Vasilyka/Voice-planner/README.md

# Voice-planner

Портативный голосовой планировщик на ESP32-S3. Удерживайте кнопку, чтобы записать команду, и отпустите для отправки. Локальный сервер распознаёт речь через Yandex SpeechKit, разбирает команду через YandexGPT и формирует таблицу дел для e-paper-дисплея.

Голосом можно добавлять, удалять, отмечать выполненными и восстанавливать дела.

- [Компоненты и схема](hardware/README.md)
- [Прошивка и подключение](firmware/README.md)
- [Запуск сервера и голосовые команды](server/README.md)
- [Архитектура](docs/ARCHITECTURE.md)
