Vasilyka/Voice-planner/docs/Лифлет_Voice_Planner.docx

Голосовой Планировщик с AI

## Название и описание

Портативное устройство для голосового ввода дел и просмотра списка на экране. Пользователь удерживает кнопку и произносит команду; запись передаётся на сервер для распознавания. Результат обработки возвращается на дисплей в виде таблицы задач.

## Команда

Участники: Калачиков Василий, Б04-507.

Роли: весь пласт задач лежит на единственном человеке в команде.

## Telegram и GitHub

GitHub Telegram

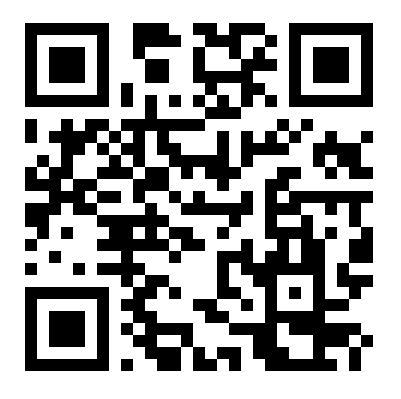
[picture p1: figure]
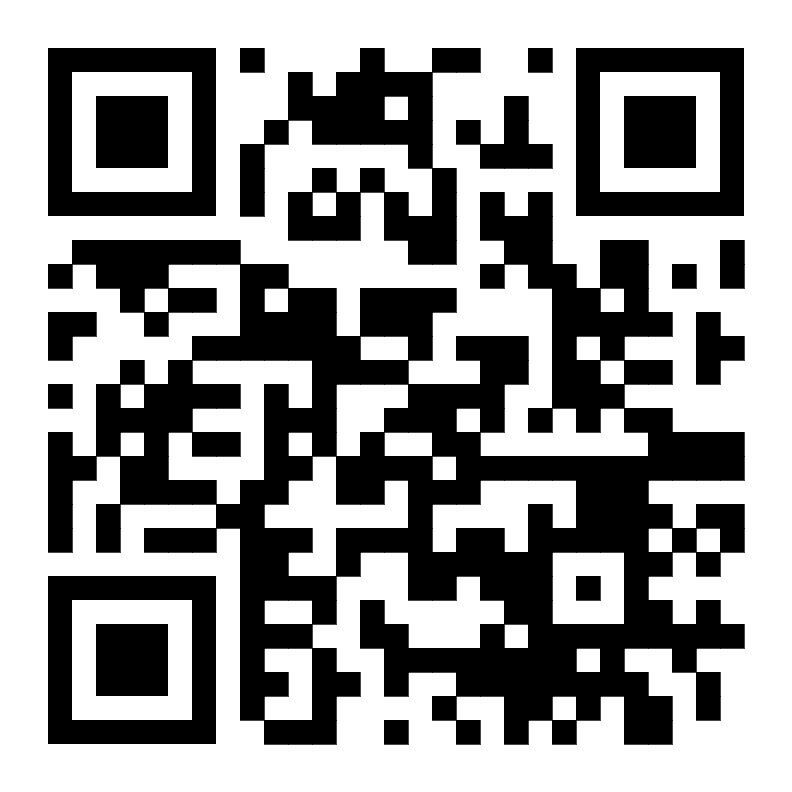
[picture p2: figure]

Github: Vasilyka/Voice-planner

Telegram: @Quantumxy

# Технические характеристики устройства

## Электронные компоненты

Сенсор: цифровой микрофон INMP441 — воспринимает звук и речь пользователя через I2S.

Микроконтроллер: ESP32-S3 — запись, обмен по Wi-Fi и управление экраном.

Вывод и индикация: e-paper GDEM035T81 с адаптером DESPI-C02 и два светодиода. Механических актуаторов нет.

## Основные параметры:

• Экран: 3,5″, 184 × 384 пикселя.
• Аудио: WAV, моно, 16 бит, 16 кГц.
• Запись: до 30 с при доступной PSRAM.
• Связь: Wi-Fi, передача по HTTP.

## Функциональная схема

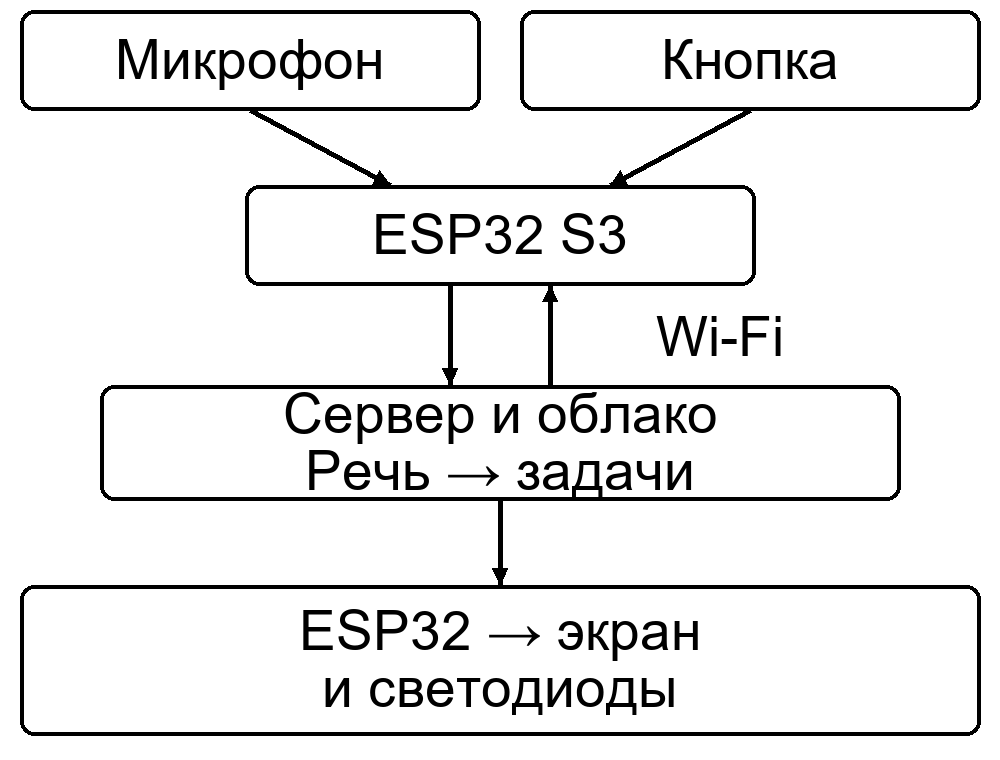
[picture p3: figure]

# Сценарий использования

## Ввод информации и управление

1. Включить устройство и дождаться подключения к Wi-Fi.

2. Удерживать кнопку и произнести дело, например: «Завтра в шесть вечера лекция по физике».

3. Отпустить кнопку. Устройство отправит запись на сервер; после обработки обновится список дел.

В программной версии предусмотрены голосовые команды добавления, удаления, выполнения и восстановления дел. Например: «Удали задачу номер пять».

## Получение информации

Экран показывает состояние устройства, обработку записи и таблицу дел. Светодиоды сигнализируют о записи или передаче и подключении к Wi-Fi.

## Настройка

Сеть Wi-Fi и адрес сервера задаются перед загрузкой прошивки. Для распознавания нужны работающий сервер, доступ в интернет и настроенный облачный ключ.

# Инженерная задача

Основной технический вызов — размещение всех модулей в портативном корпусе с безрамочным экраном.

Также нужно объединить запись звука, сетевой обмен и медленное обновление e-paper так, чтобы обновление экрана не прерывало запись речи. Для этого обработка дисплея и получение результатов с сервера вынесены в отдельные задачи.

## Результаты испытаний

Время обработки: ~ секунда
Автономность: (нужно проверить)
Габариты и масса: (нужно измерить)

# Прогресс проекта

Статус: первый рабочий прототип.

## Было заявлено

Голосовой ввод дел и вывод списка на экран.

## Сделано

Распознавание речи и вывод дел на экран работают. Добавлены команды выполнения, удаления и восстановления дел.

## Осталось

Добавить 2 светодиода, улучшить прошивку.

Можно добавить 2 кнопки управления и реализовать прошивку для них.

# Визуализация устройства

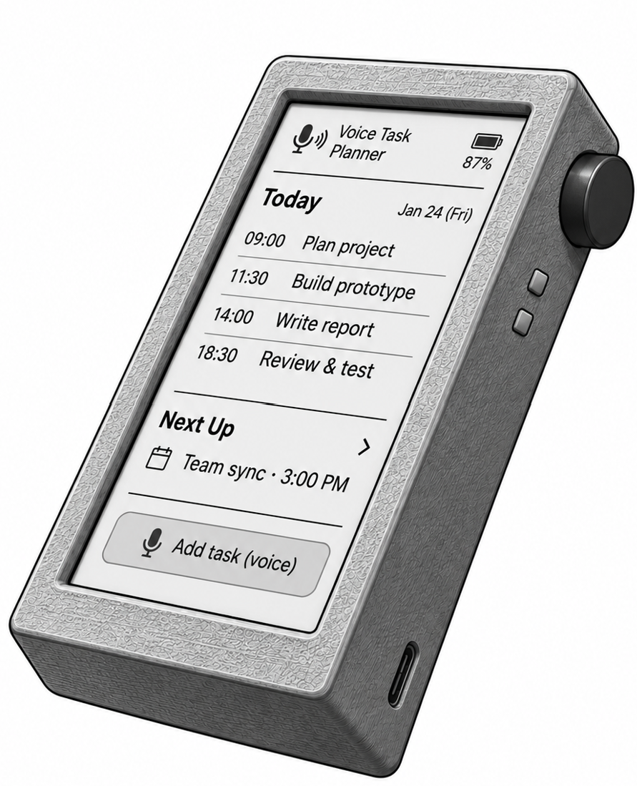
[picture p4: figure]

Эскиз
