Vasilyka/Voice-planner/hardware/Схема подключения 2.jpg

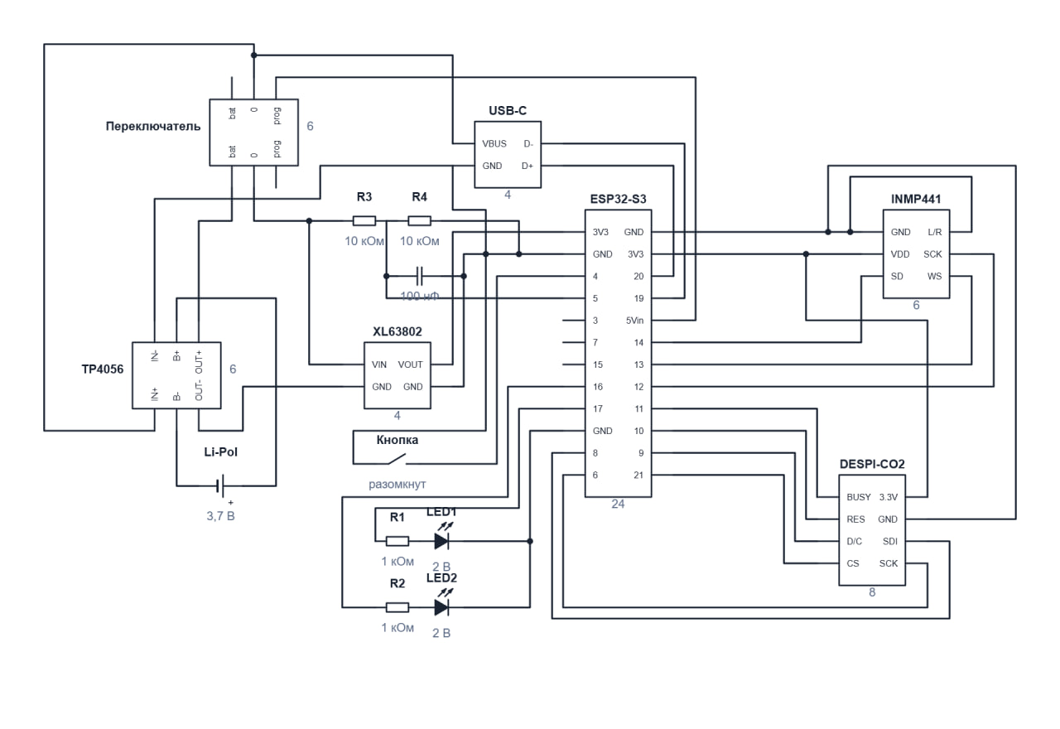
hardware/Схема подключения 2.jpg
