Vasilyka/Voice-planner/firmware/voice_planner/board_pins.h

#pragma once

constexpr int MIC_SCK = 12;
constexpr int MIC_WS = 13;
constexpr int MIC_SD = 14;
constexpr int BUTTON_PIN = 4;
constexpr int LED_PIN = 17;       // LED1: запись / передача.
constexpr int WIFI_LED_PIN = 16;  // LED2: соединение Wi-Fi.

constexpr int EPD_BUSY = 11;
constexpr int EPD_RST = 10;
constexpr int EPD_DC = 9;
constexpr int EPD_CS = 21;
constexpr int EPD_MOSI = 8;
constexpr int EPD_SCK = 6;
constexpr int BATTERY_ADC = 5;    // Зарезервирован, измерение пока не используется.
