Vasilyka/Voice-planner/(commit log)

2026-11-07 тест
2026-11-07 йоу!
2026-11-07 добавил игнор
2026-11-07 Добавить прототип записи WAV с INMP441 и сервер приёма
2026-11-07 Добавить отдельный тест e-paper дисплея и таблицу подключения
2026-11-07 Описать этапы разработки и архитектуру Voice-planner
2026-11-07 Запись и отправка голоса на сервер
2026-11-07 апдейт
2026-11-11 Сделана полноценная прошивка первого прототипа
2026-11-12 Привёл реп к норм виду
